LuleaFormulaStudent/BrakeSignal_PreAmp/BrakeSignal_PreAmp KiCad/BrakeSignal_PreAmp.kicad_pcb

## KiCad design BrakeSignal_PreAmp KiCad/BrakeSignal_PreAmp.kicad_pcb (2025-05-14)

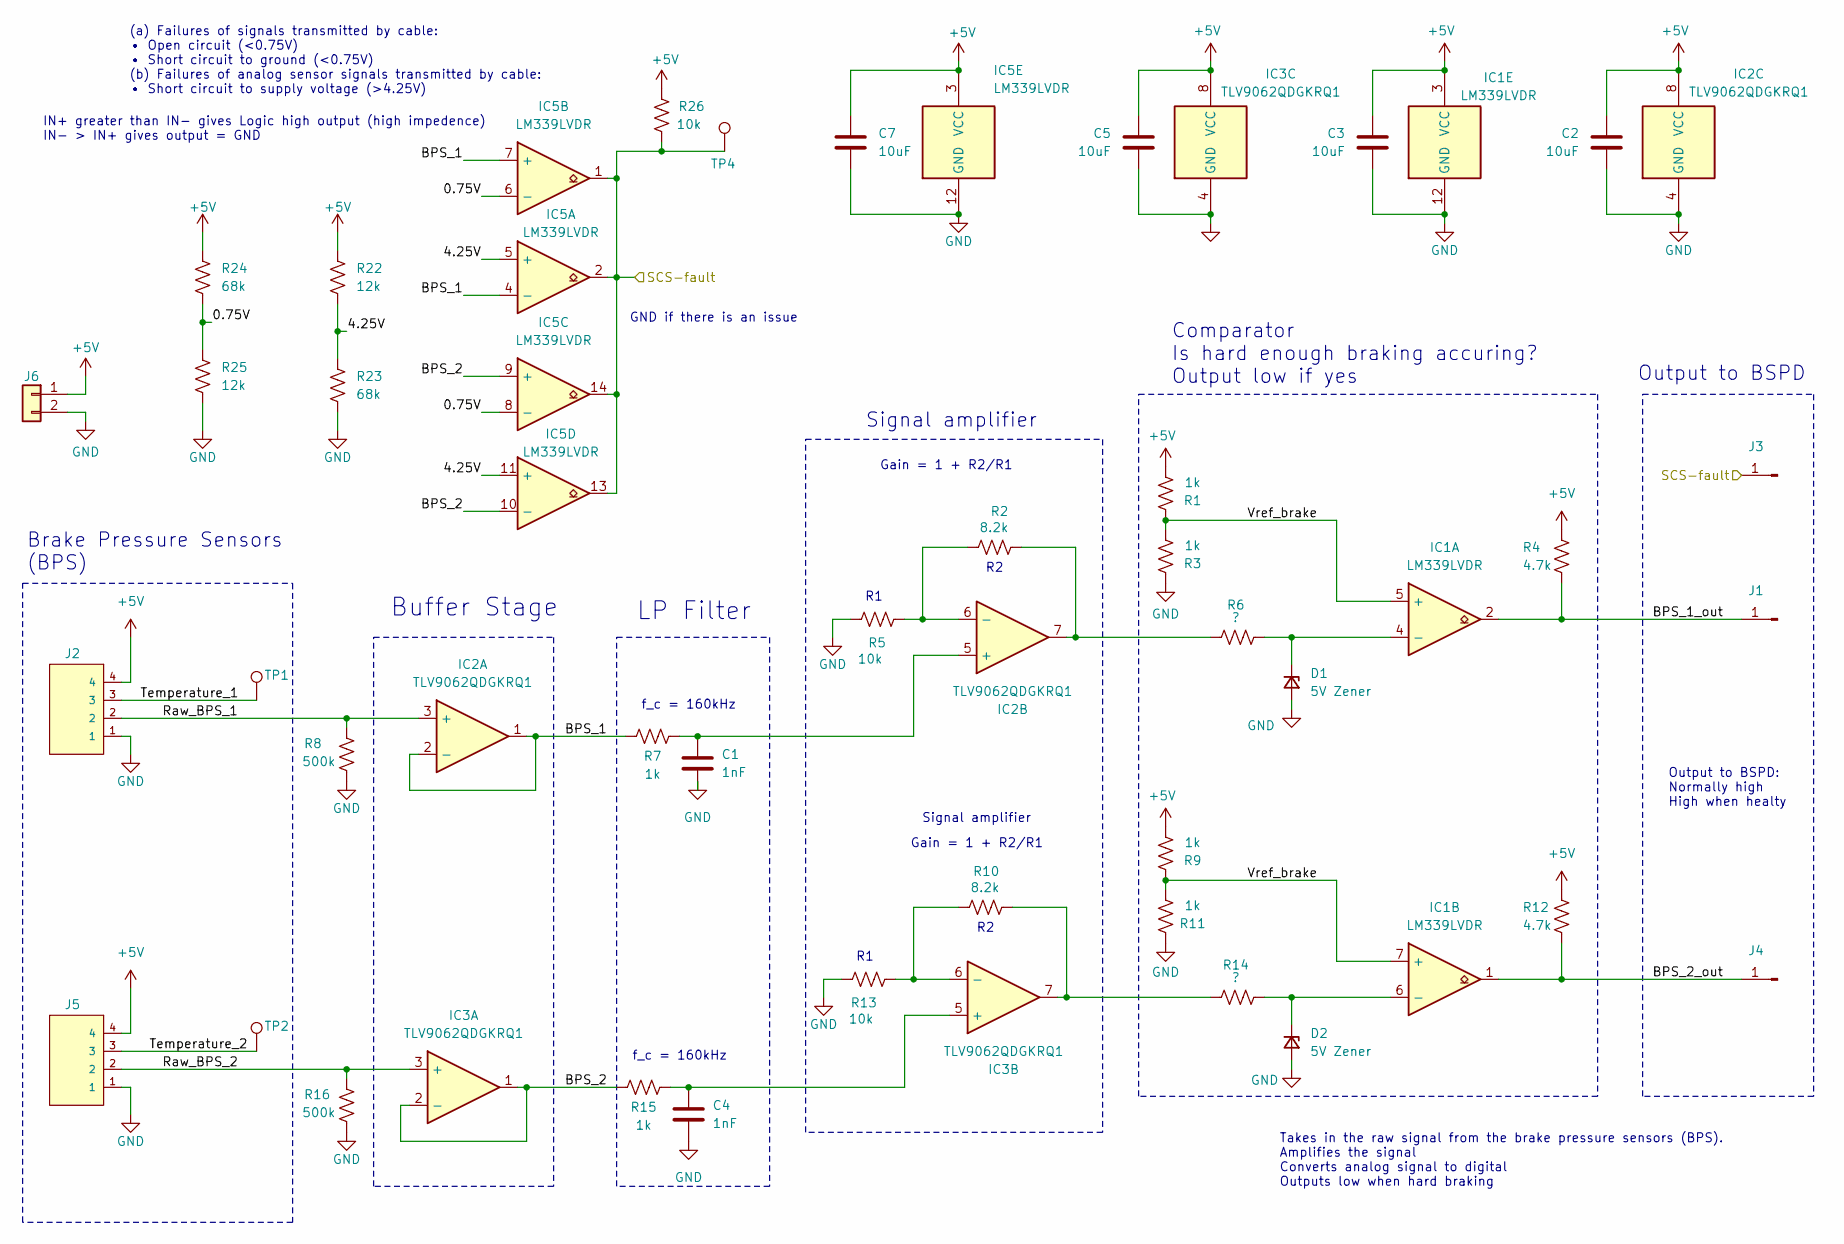
[picture p1: schematic BrakeSignal_PreAmp.kicad_sch, BSPD PreAmp]

Parts:
C1, C4: 1nF; C_0805_2012Metric
C2, C3, C5, C7: 10uF; C_0603_1608Metric
D1, D2: 5V Zener
IC1, IC5: LM339LVDR; SOIC127P600X175-14N; Mouser Part Number 595-LM339LVDR
IC2, IC3: TLV9062QDGKRQ1; SOP65P490X110-8N; Mouser Part Number 595-TLV9062QDGKRQ1
J1, J3, J4: Conn_01x01_Pin; PinSocket_1x01_P2.54mm_Vertical
J2, J5: 4P Droit 22-11-2042; JST_XH_B4B-XH-A_1x04_P2.50mm_Vertical; PARTREV BD7; Mouser Part Number 538-22-11-2042
J6: Conn_01x02; JST_XH_B2B-XH-A_1x02_P2.50mm_Vertical
R1, R3, R7, R9, R11, R15: 1k; R_0805_2012Metric
R2, R10: 8.2k; R_0805_2012Metric
R4, R12: 4.7k; R_0805_2012Metric
R5, R13, R26: 10k; R_0805_2012Metric
R6, R14: ?; R_0805_2012Metric
R8, R16: 500k; R_0805_2012Metric
R22, R25: 12k; R_0805_2012Metric
R23, R24: 68k; R_0805_2012Metric
TP1, TP2, TP4: TestPoint; TestPoint_Pad_D1.5mm

Connections:
+5V: C2.1, C3.1, C5.1, C7.1, IC1.3 (VCC), IC2.8 (VCC), IC3.8 (VCC), IC5.3 (VCC), J2.4, J5.4, J6.1, R1.2, R4.1, R9.2, R12.1, R22.1, R24.1, R26.1
/0.75V: IC5.6 (-), IC5.8 (-), R24.2, R25.1
/4.25V: IC5.5 (+), IC5.11 (+), R22.2, R23.1
/BPS_1: IC2.1, IC2.2 (-), IC5.4 (-), IC5.7 (+), R7.1
/BPS_1_out: IC1.2, J1.1, R4.2
/BPS_2: IC3.1, IC3.2 (-), IC5.9 (+), IC5.10 (-), R15.1
/BPS_2_out: IC1.1, J4.1, R12.2
/Raw_BPS_1: IC2.3 (+), J2.2, R8.1
/Raw_BPS_2: IC3.3 (+), J5.2, R16.1
/SCS-fault: IC5.1, IC5.2, IC5.13, IC5.14, J3.1, R26.2, TP4.1
/Temperature_1: J2.3, TP1.1
/Temperature_2: J5.3, TP2.1
/Vref_brake: IC1.5 (+), IC1.7 (+), R1.1, R3.2, R9.1, R11.2
GND: C1.2, C2.2, C3.2, C4.2, C5.2, C7.2, D1.2 (A), D2.2 (A), IC1.12 (GND), IC2.4 (GND), IC3.4 (GND), IC5.12 (GND), J2.1, J5.1, J6.2, R3.1, R5.1, R8.2, R11.1, R13.1, R16.2, R23.2, R25.2
unnamed: D1.1 (K), IC1.4 (-), R6.1
unnamed: D2.1 (K), IC1.6 (-), R14.1
unnamed: IC2.7, R2.2, R6.2
unnamed: C1.1, IC2.5 (+), R7.2
unnamed: IC2.6 (-), R2.1, R5.2
unnamed: IC3.7, R10.2, R14.2
unnamed: C4.1, IC3.5 (+), R15.2
unnamed: IC3.6 (-), R10.1, R13.2

Notes on the sheet:
Brake Pressure Sensors (BPS)
LP Filter
GND if there is an issue
(a) Failures of signals transmitted by cable: • Open circuit (<0.75V) • Short circuit to ground (<0.75V) (b) Failures of analog sensor signals transmitted by cable: • Short circuit to supply voltage (>4.25V)
Gain = 1 + R2/R1
Signal amplifier
Output to BSPD
IN+ greater than IN- gives Logic high output (high impedence) IN- > IN+ gives output = GND
Output to BSPD: Normally high High when healty
Takes in the raw signal from the brake pressure sensors (BPS). Amplifies the signal Converts analog signal to digital Outputs low when hard braking
Buffer Stage
Comparator Is hard enough braking accuring? Output low if yes
f_c = 160kHz

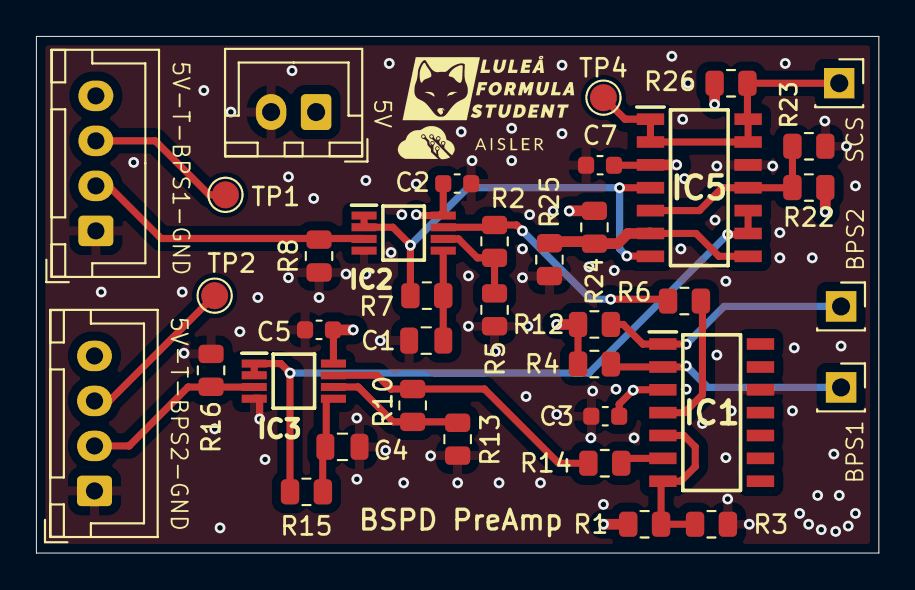
[picture p2: board BrakeSignal_PreAmp.kicad_pcb from above]

Board: 4 copper layers, 46.8 x 28.7 mm, 38 parts (0 on the bottom side), 22 nets.
