LuleaFormulaStudent/BrakeSignal_PreAmp/(commit log)

2025-05-13 Schematic done
    [BrakeSignal_PreAmp.kicad_sch]
2025-05-14 Routing done, no errors. Zener missing
    [BrakeSignal_PreAmp.kicad_pcb, BrakeSignal_PreAmp.kicad_sch]
